OmniXRI/OpenQSignage/Figures/OpenQSignage_Fig03_Circuit.jpg

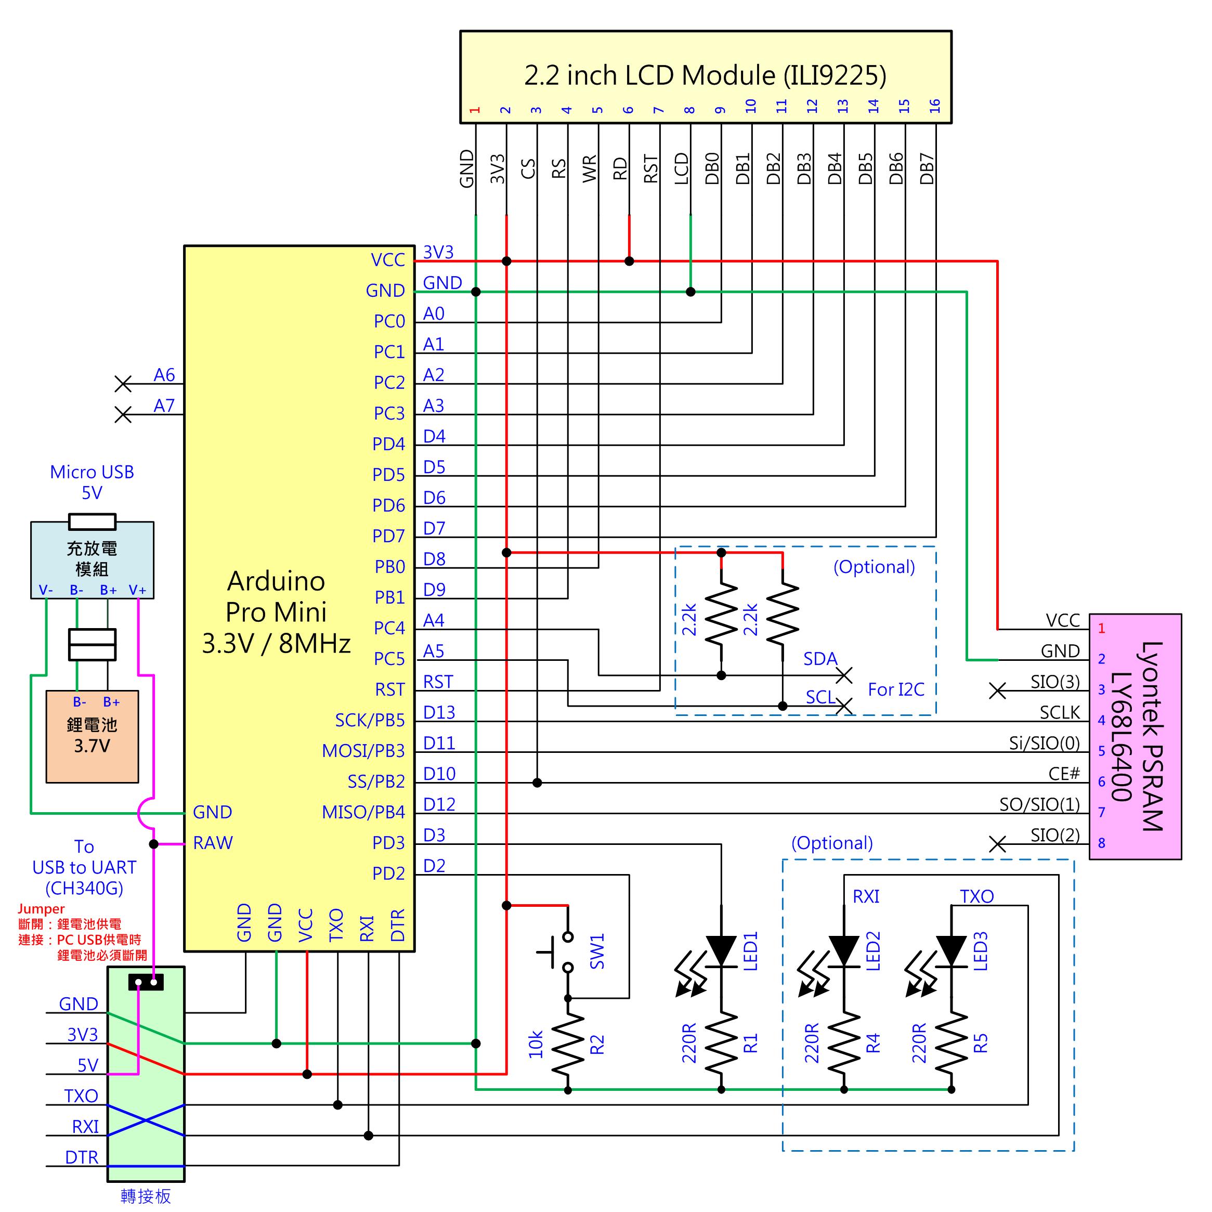
Figures/OpenQSignage_Fig03_Circuit.jpg
