OmniXRI/OpenQSignage/Figures/OpenQSignage_Fig04_Layout.jpg

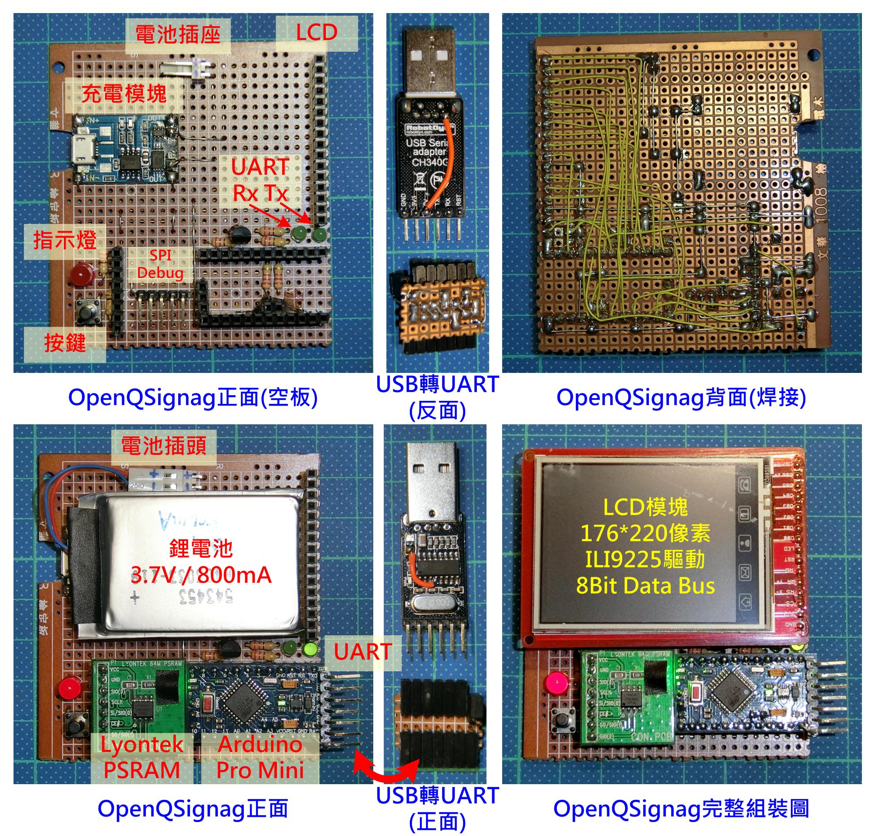
Figures/OpenQSignage_Fig04_Layout.jpg
