OmniXRI/OpenQSignage/Figures/OpenQSignage_Fig05_LCD.jpg

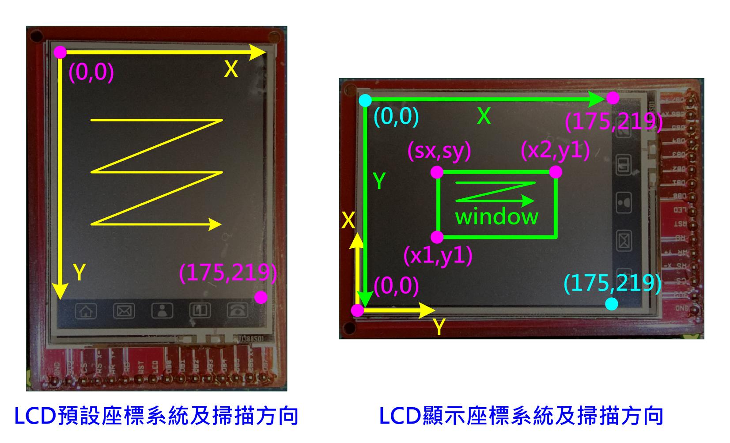
Figures/OpenQSignage_Fig05_LCD.jpg
