OmniXRI/OpenQSignage/Figures/OpenQSignage_Fig06_UART.jpg

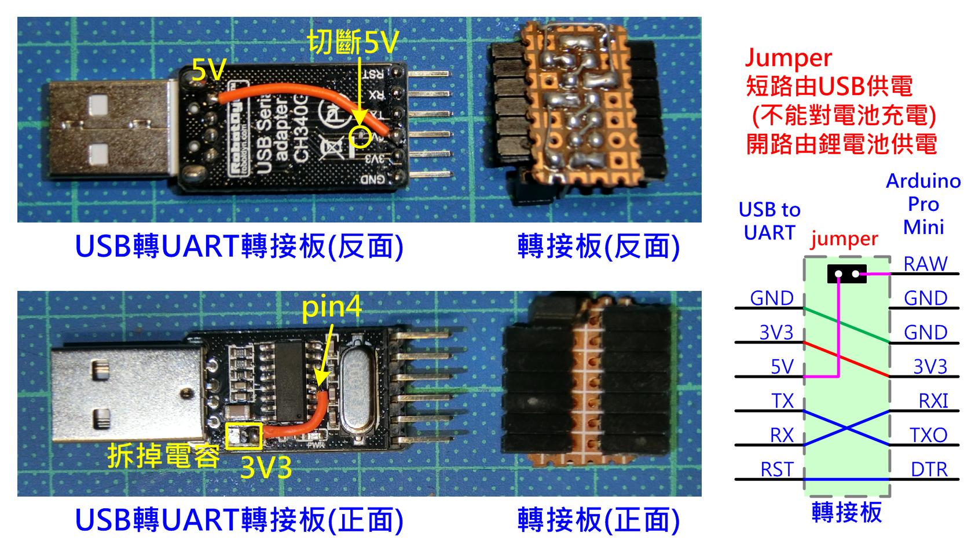
Figures/OpenQSignage_Fig06_UART.jpg
