OmniXRI/OpenQSignage/Figures/OpenQSignage_Fig07_PSRAM.jpg

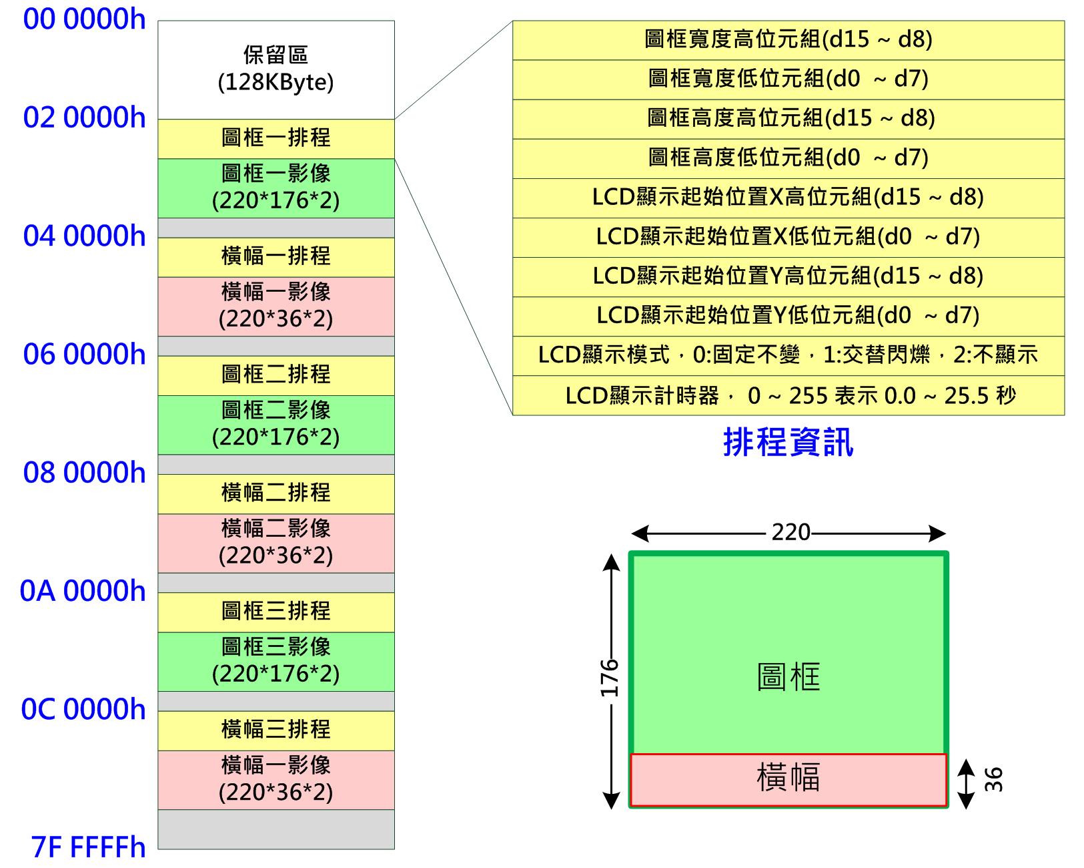
Figures/OpenQSignage_Fig07_PSRAM.jpg
