OmniXRI/OpenQSignage/Figures/OpenQSignage_Fig08_Frame.jpg

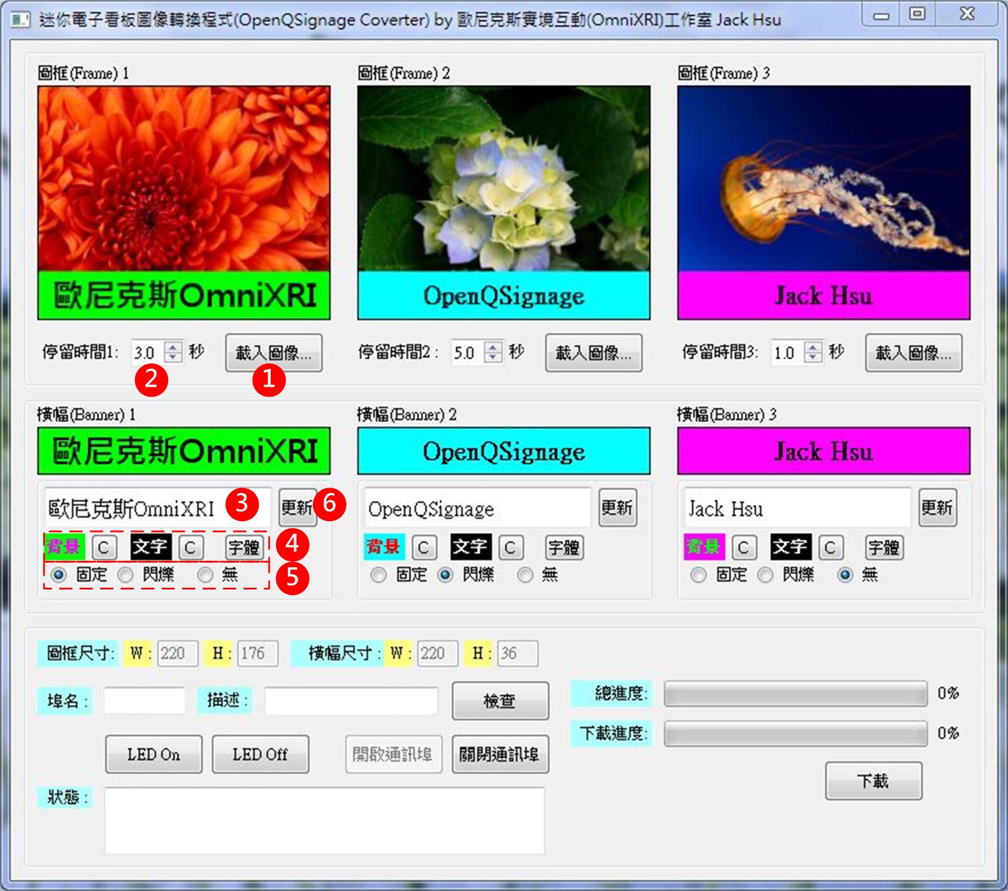
Figures/OpenQSignage_Fig08_Frame.jpg
