OmniXRI/OpenQSignage/Figures/OpenQSignage_Fig09_download.jpg

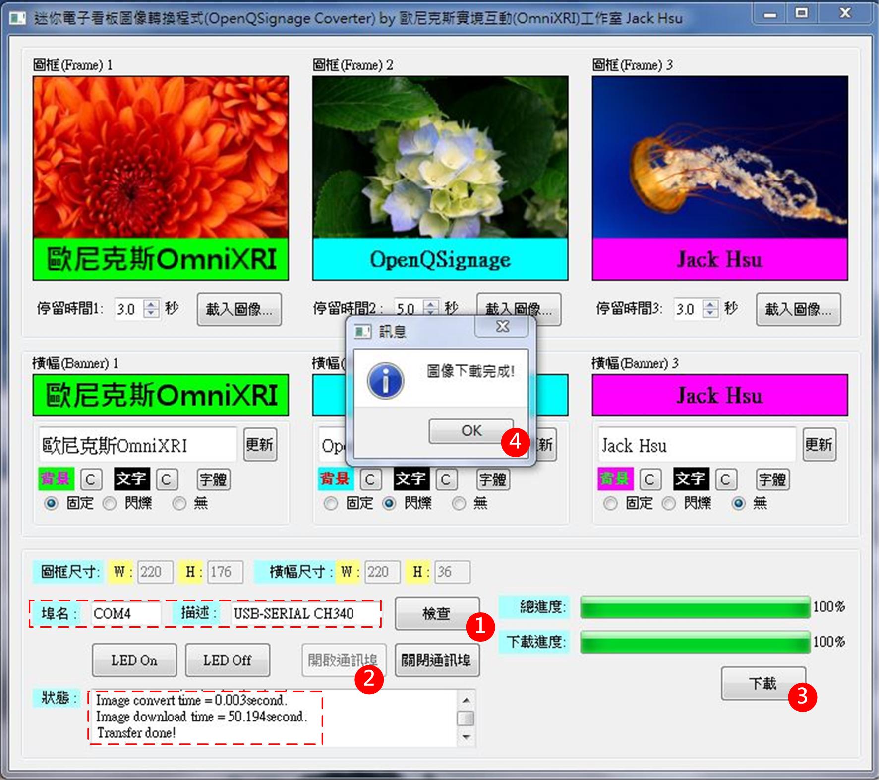
Figures/OpenQSignage_Fig09_download.jpg
